davisdriving/sdp27/README.md

# sdp27
Code + Documentation for team 27's ECE senior design project at UMass Amherst, a wheeled bipedal robot built to run CFM-based ergodic coverage algorithms and execute them in real time. Its awesome.
Refer to /important to see what really makes all the difference.
