davisdriving/sdp27/hardware/hardware_notes.md

currently contains the v1 schematic of the controller PCB
