davisdriving/sdp27/hardware/kicad_schematic_v1.png

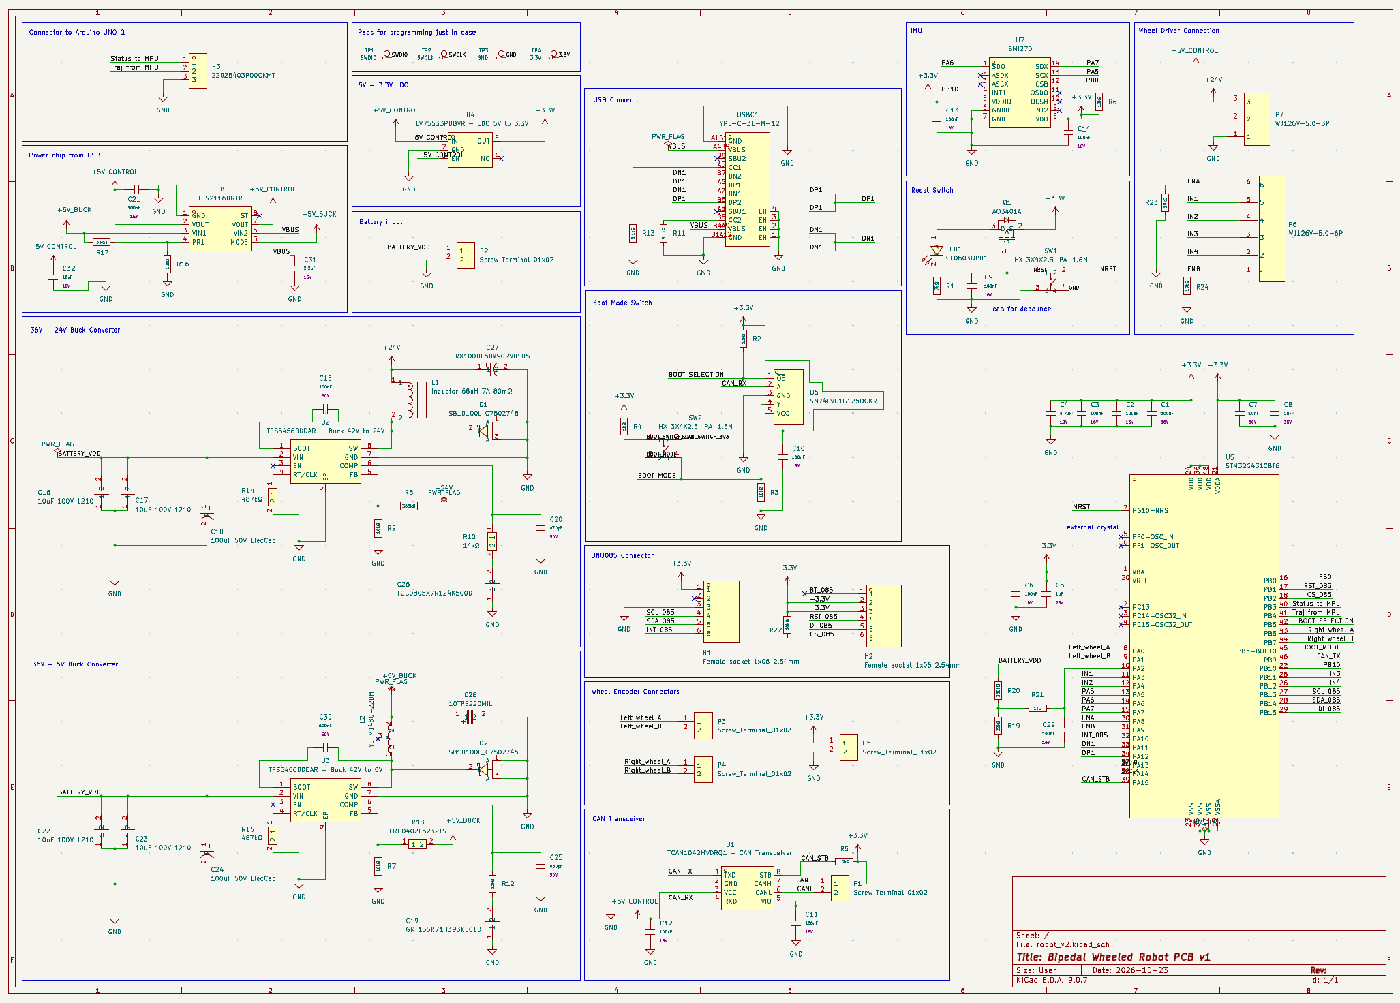
hardware/kicad_schematic_v1.png
