davisdriving/sdp27/hardware/robot_v1.kicad_sch

## KiCad design hardware/robot_v1.kicad_sch (2026-11-13)

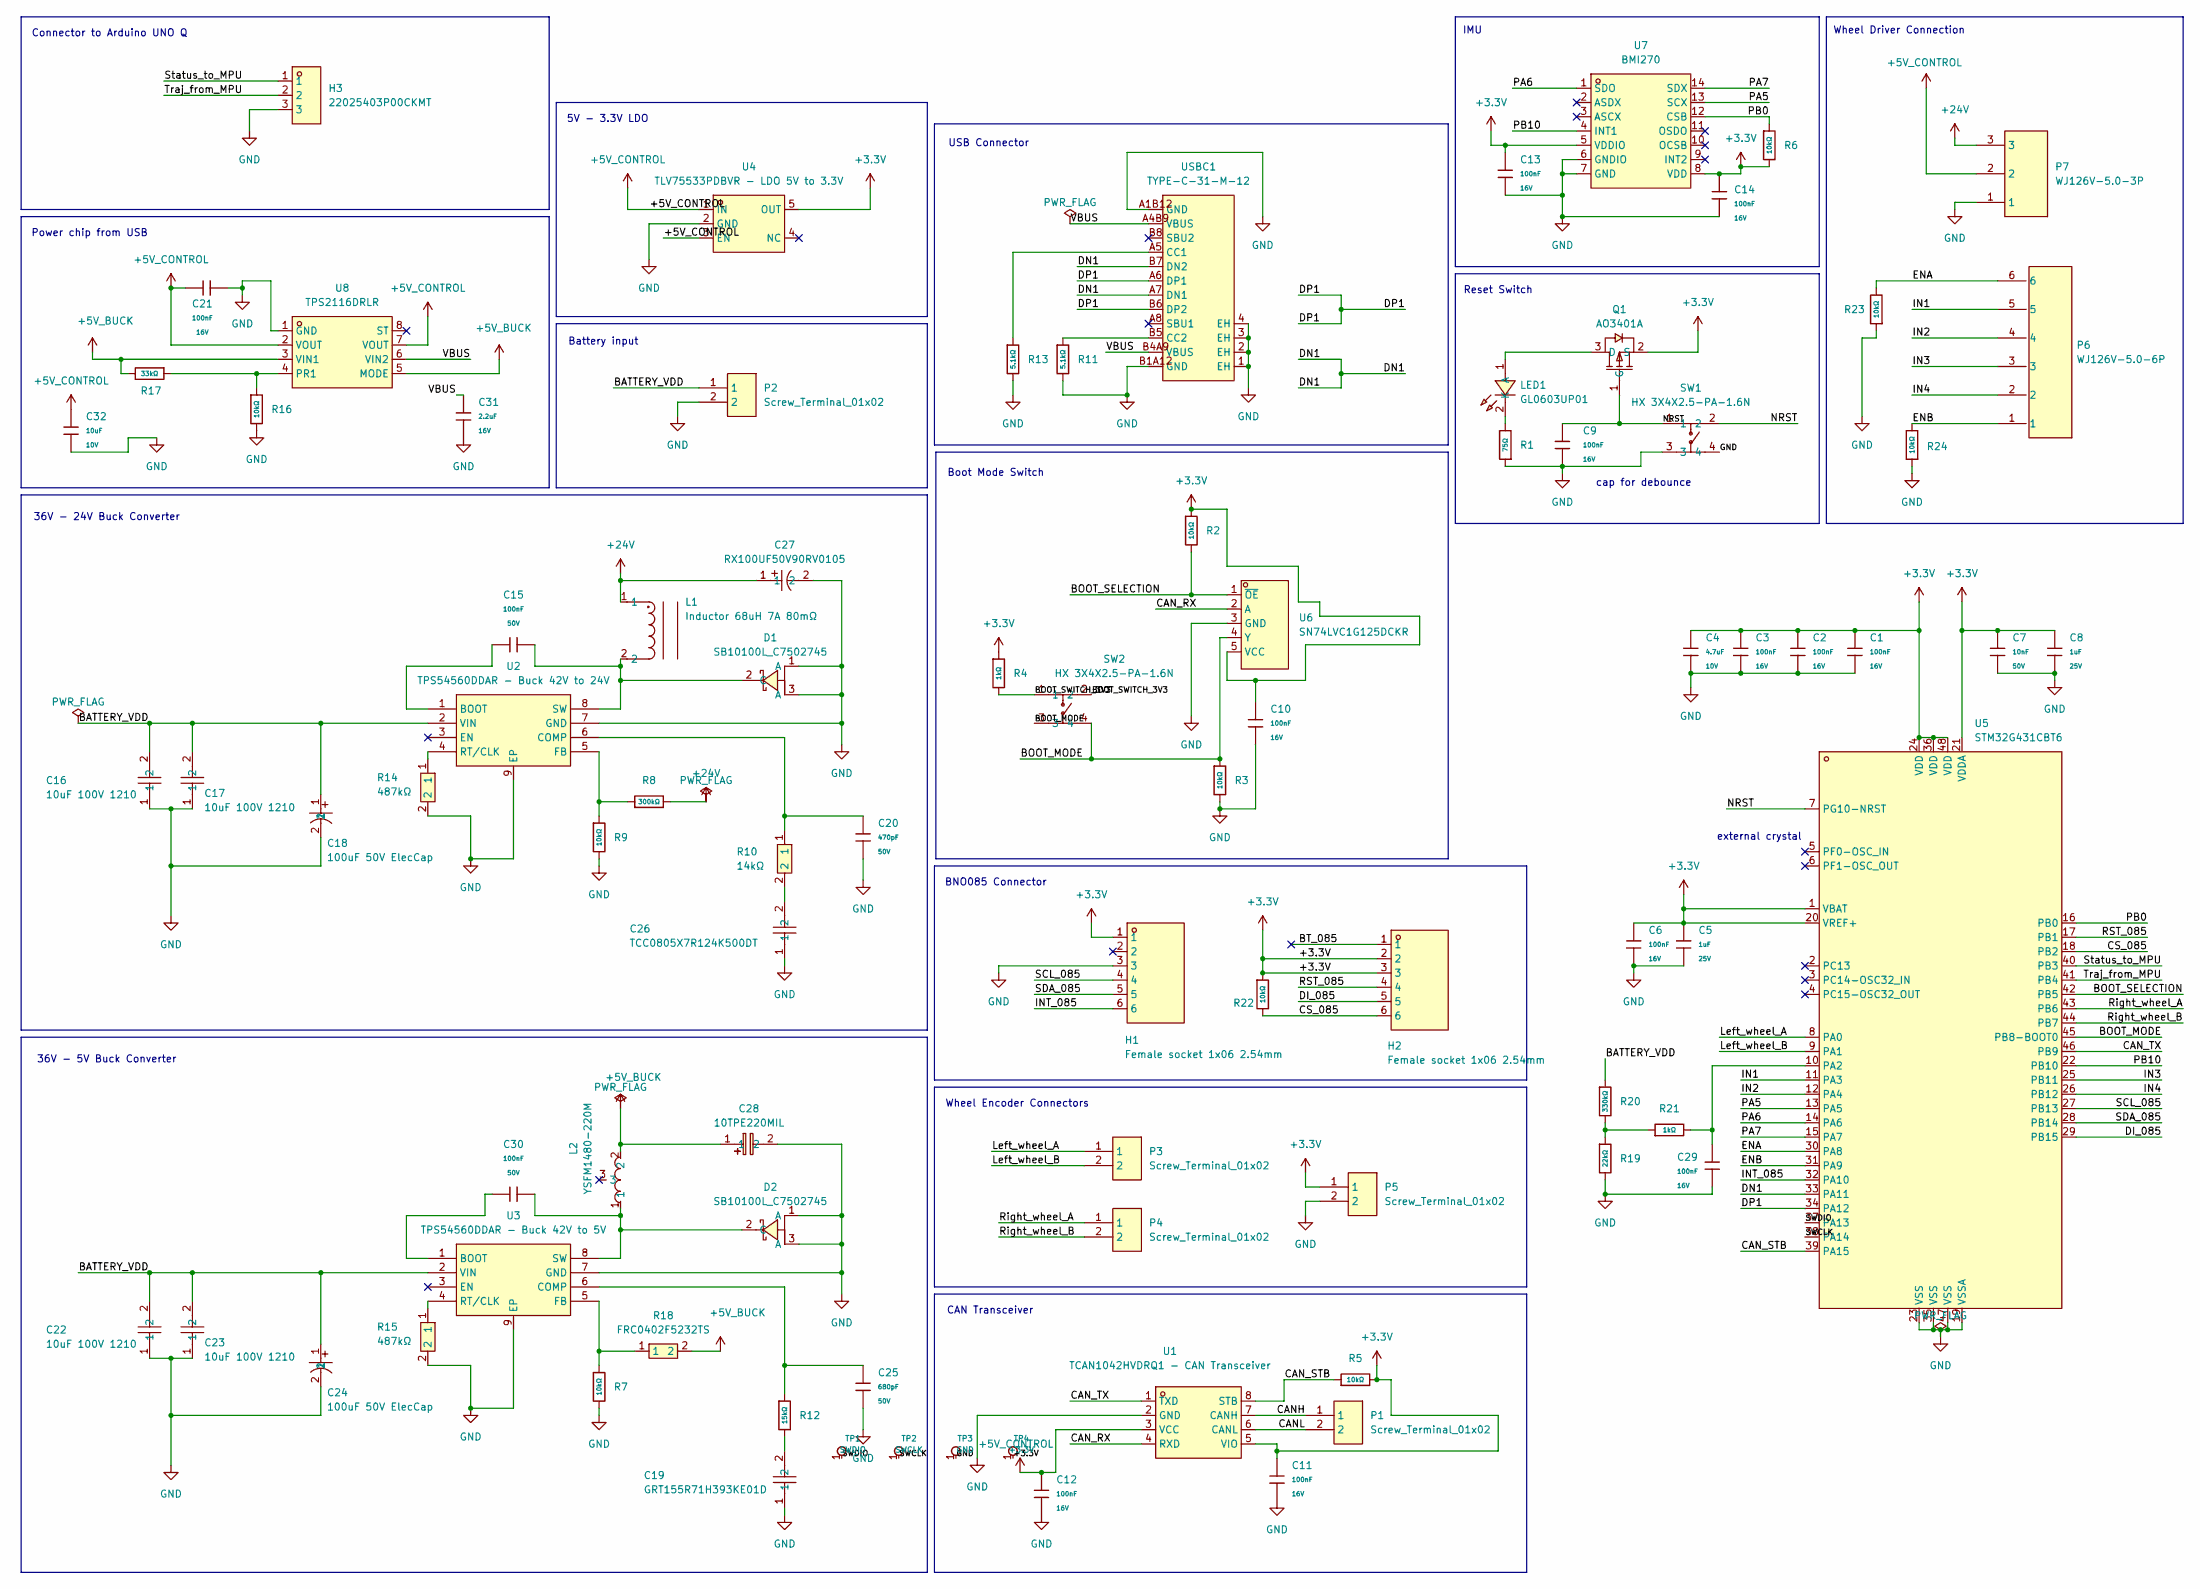
[picture p2: schematic robot_v1.kicad_sch]

Parts:
C1: 100nF; C1; Voltage Rated 16V; Tolerance ±10%; Part CL05B104KO5NNNC; LCSC C1525
C2: 100nF; C2; Voltage Rated 16V; Tolerance ±10%; Part CL05B104KO5NNNC; LCSC C1525
C3: 100nF; C3; Voltage Rated 16V; Tolerance ±10%; Part CL05B104KO5NNNC; LCSC C1525
C4: 4.7uF; C4; Voltage Rated 10V; Tolerance ±20%; Part CL05A475MP5NRNC; LCSC C23733
C5: 1uF; C5; Voltage Rated 25V; Tolerance ±10%; Part CL05A105KA5NQNC; LCSC C52923
C6: 100nF; C6; Voltage Rated 16V; Tolerance ±10%; Part CL05B104KO5NNNC; LCSC C1525
C7: 10nF; C7; Voltage Rated 50V; Tolerance ±10%; Part CL05B103KB5NNNC; LCSC C15195
C8: 1uF; C8; Voltage Rated 25V; Tolerance ±10%; Part CL05A105KA5NQNC; LCSC C52923
C9: 100nF; C9; Voltage Rated 16V; Tolerance ±10%; Part CL05B104KO5NNNC; LCSC C1525
C10: 100nF; C10; Voltage Rated 16V; Tolerance ±10%; Part CL05B104KO5NNNC; LCSC C1525
C11: 100nF; C11; Voltage Rated 16V; Tolerance ±10%; Part CL05B104KO5NNNC; LCSC C1525
C12: 100nF; C12; Voltage Rated 16V; Tolerance ±10%; Part CL05B104KO5NNNC; LCSC C1525
C13: 100nF; C13; Voltage Rated 16V; Tolerance ±10%; Part CL05B104KO5NNNC; LCSC C1525
C14: 100nF; C14; Voltage Rated 16V; Tolerance ±10%; Part CL05B104KO5NNNC; LCSC C1525
C15: 100nF; C15; Voltage Rated 50V; Tolerance ±10%; Part CL05B104KB54PNC; LCSC C307331
C16: 10uF 100V 1210; C16; MPN FS32X106K101EGG; LCSC Part C5156756
C17: 10uF 100V 1210; C17; MPN FS32X106K101EGG; LCSC Part C5156756
C18: 100uF 50V ElecCap; C18; MPN RVT1H101M0810; LCSC Part C72480
C19: GRT155R71H393KE01D; C19; MPN GRT155R71H393KE01D; LCSC Part C6627612
C20: 470pF; C20; Voltage Rated 50V; Tolerance ±10%; Part 0402B471K500NT; LCSC C1537
C21: 100nF; C21; Voltage Rated 16V; Tolerance ±10%; Part CL05B104KO5NNNC; LCSC C1525
C22: 10uF 100V 1210; C22; MPN FS32X106K101EGG; LCSC Part C5156756
C23: 10uF 100V 1210; C23; MPN FS32X106K101EGG; LCSC Part C5156756
C24: 100uF 50V ElecCap; C24; MPN RVT1H101M0810; LCSC Part C72480
C25: 680pF; C25; Voltage Rated 50V; Tolerance ±10%; Part 0603B681K500NT; LCSC C1630
C26: TCC0805X7R124K500DT; C26; MPN TCC0805X7R124K500DT; LCSC Part C376931
C27: RX100UF50V90RV0105; C27; MPN RX100UF50V90RV0105; LCSC Part C3445238
C28: 10TPE220MIL; C28; MPN 10TPE220MIL; LCSC Part C347538
C29: 100nF; C29; Voltage Rated 16V; Tolerance ±10%; Part CL05B104KO5NNNC; LCSC C1525
C30: 100nF; C30; Voltage Rated 50V; Tolerance ±10%; Part CL05B104KB54PNC; LCSC C307331
C31: 2.2uF; C31; Voltage Rated 16V; Tolerance ±10%; Part CL10A225KO8NNNC; LCSC C23630
C32: 10uF; C32; Voltage Rated 10V; Tolerance ±10%; Part CL10A106KP8NNNC; LCSC C19702
D1: SB10100L_C7502745; D1; MPN SB10100L; LCSC Part C7502745
D2: SB10100L_C7502745; D2; MPN SB10100L; LCSC Part C7502745
H1: Female socket 1x06 2.54mm; H1; MPN A2541HWV-6P; LCSC Part C225503
H2: Female socket 1x06 2.54mm; H2; MPN A2541HWV-6P; LCSC Part C225503
H3: 22025403P00CKMT; H3; MPN B-2200S03P-A120; LCSC Part C146690
L1: Inductor 68uH 7A 80mΩ; L1; MPN SMMS1770-680M; LCSC Part C2976972
L2: YSFM1480-220M; L2; MPN YSFM1480-220M; LCSC Part C7433102
LED1: GL0603UP01; LED1; MPN GL0603UP01; LCSC Part C51933299
P1: Screw_Terminal_01x02; P1; MPN WJ127-5.0-02P-14-00A; LCSC Part C3703
P2: Screw_Terminal_01x02; P2; MPN WJ127-5.0-02P-14-00A; LCSC Part C3703
P3: Screw_Terminal_01x02; P3; MPN WJ127-5.0-02P-14-00A; LCSC Part C3703
P4: Screw_Terminal_01x02; P4; MPN WJ127-5.0-02P-14-00A; LCSC Part C3703
P5: Screw_Terminal_01x02; P5; MPN WJ127-5.0-02P-14-00A; LCSC Part C3703
P6: WJ126V-5.0-6P; P6; MPN WJ126V-5.0-06P-14-00A; LCSC Part C8379
P7: WJ126V-5.0-3P; P7; MPN WJ126V-5.0-03P-14-00A; LCSC Part C8401
Q1: AO3401A; Q1; MPN AO3401A; LCSC Part C15127
R1: 75Ω; R1; Overload Voltage (Max) 50V; Tolerance ±1%; Part 0402WGF750JTCE; LCSC C25133
R2: 10kΩ; R2; Overload Voltage (Max) 50V; Tolerance ±1%; Part 0402WGF1002TCE; LCSC C25744
R3: 10kΩ; R3; Overload Voltage (Max) 50V; Tolerance ±1%; Part 0402WGF1002TCE; LCSC C25744
R4: 1kΩ; R4; Overload Voltage (Max) 50V; Tolerance ±1%; Part 0402WGF1001TCE; LCSC C11702
R5: 10kΩ; R5; Overload Voltage (Max) 50V; Tolerance ±1%; Part 0402WGF1002TCE; LCSC C25744
R6: 10kΩ; R6; Overload Voltage (Max) 50V; Tolerance ±1%; Part 0402WGF1002TCE; LCSC C25744
R7: 10kΩ; R7; Overload Voltage (Max) 50V; Tolerance ±1%; Part 0402WGF1002TCE; LCSC C25744
R8: 300kΩ; R8; Overload Voltage (Max) 50V; Tolerance ±1%; Part 0402WGF3003TCE; LCSC C25774
R9: 10kΩ; R9; Overload Voltage (Max) 50V; Tolerance ±1%; Part 0402WGF1002TCE; LCSC C25744
R10: 14kΩ; R10; MPN FRC0603F1402TS; LCSC Part C2930066
R11: 5.1kΩ; R11; Overload Voltage (Max) 50V; Tolerance ±1%; Part 0402WGF5101TCE; LCSC C25905
R12: 15kΩ; R12; Overload Voltage (Max) 50V; Tolerance ±1%; Part 0402WGF1502TCE; LCSC C25756
R13: 5.1kΩ; R13; Overload Voltage (Max) 50V; Tolerance ±1%; Part 0402WGF5101TCE; LCSC C25905
R14: 487kΩ; R14; MPN CRCW0603487KFKEA; LCSC Part C2076638
R15: 487kΩ; R15; MPN CRCW0603487KFKEA; LCSC Part C2076638
R16: 10kΩ; R16; Overload Voltage (Max) 50V; Tolerance ±1%; Part 0402WGF1002TCE; LCSC C25744
R17: 33kΩ; R17; Overload Voltage (Max) 50V; Tolerance ±1%; Part 0402WGF3302TCE; LCSC C25779
R18: FRC0402F5232TS; R18; MPN FRC0402F5232TS; LCSC Part C2998086
R19: 22kΩ; R19; Overload Voltage (Max) 50V; Tolerance ±1%; Part 0402WGF2202TCE; LCSC C25768
R20: 330kΩ; R20; Overload Voltage (Max) 75V; Tolerance ±1%; Part 0603WAF3303T5E; LCSC C23137
R21: 1kΩ; R21; Overload Voltage (Max) 50V; Tolerance ±1%; Part 0402WGF1001TCE; LCSC C11702
R22: 10kΩ; R22; Overload Voltage (Max) 50V; Tolerance ±1%; Part 0402WGF1002TCE; LCSC C25744
R23: 10kΩ; R23; Overload Voltage (Max) 50V; Tolerance ±1%; Part 0402WGF1002TCE; LCSC C25744
R24: 10kΩ; R24; Overload Voltage (Max) 50V; Tolerance ±1%; Part 0402WGF1002TCE; LCSC C25744
SW1: HX 3X4X2.5-PA-1.6N; SW1; MPN HX 3x4x2.5-PA-1.6N; LCSC Part C55200587
SW2: HX 3X4X2.5-PA-1.6N; SW2; MPN HX 3x4x2.5-PA-1.6N; LCSC Part C55200587
TP1: SWDIO; TP1
TP2: SWCLK; TP2
TP3: GND; TP3
TP4: +3.3V; TP4
U1: TCAN1042HVDRQ1 - CAN Transceiver; U1; MPN TCAN1042HVDRQ1; LCSC Part C485807
U2: TPS54560DDAR - Buck 42V to 24V; SOIC-8_L5.0-W4.0-P1.27-LS6.0-BL-EP2.0; MPN TPS54560DDAR; LCSC Part C31966
U3: TPS54560DDAR - Buck 42V to 5V; SOIC-8_L5.0-W4.0-P1.27-LS6.0-BL-EP2.0; MPN TPS54560DDAR; LCSC Part C31966
U4: TLV75533PDBVR - LDO 5V to 3.3V; U4; MPN TLV75533PDBVR; LCSC Part C404027
U5: STM32G431CBT6; U5; MPN STM32G431CBT6; LCSC Part C529355
U6: SN74LVC1G125DCKR; U6; MPN SN74LVC1G125DCKR; LCSC Part C7833
U7: BMI270; U7; MPN BMI270; LCSC Part C2836813
U8: TPS2116DRLR; U8; MPN TPS2116DRLR; LCSC Part C3235557
USBC1: TYPE-C-31-M-12; USB-C_SMD-TYPE-C-31-M-12_1; MPN TYPE-C-31-M-12; LCSC Part C165948

Connections:
+3.3V: C1.1, C2.1, C3.1, C4.1, C5.1, C6.1, C7.1, C8.1, C10.1, C11.1, C13.1, C14.1, H1.1, H2.2, H2.3, P5.1, Q1.2 (S), R2.1, R4.1, R5.2, R6.2, R22.1, TP4.1, U1.5 (VIO), U4.5 (OUT), U5.1 (VBAT), U5.20 (VREF+), U5.21 (VDDA), U5.24 (VDD), U5.36 (VDD), U5.48 (VDD), U6.5 (VCC), U7.5 (VDDIO), U7.8 (VDD)
+5V_BUCK: C28.1, L2.2, R17.2, R18.2, U8.3 (VIN1), U8.5 (MODE)
+5V_CONTROL: C12.1, C21.1, C32.1, P7.2, U1.3 (VCC), U4.1 (IN), U4.3 (EN), U8.2 (VOUT), U8.7 (VOUT)
+24V: C27.1, L1.1, P7.3, R8.2
BATTERY_VDD: C16.2, C17.2, C18.1, C22.2, C23.2, C24.1, P2.1, R20.1, U2.2 (VIN), U3.2 (VIN)
BOOT_MODE: R3.1, SW2.3, SW2.4, U5.45 (PB8-BOOT0), U6.4 (Y)
BOOT_SELECTION: R2.2, U5.42 (PB5), U6.1 (~OE)
BOOT_SWITCH_3V3: R4.2, SW2.1, SW2.2
BT_085: H2.1
CANH: P1.1, U1.7 (CANH)
CANL: P1.2, U1.6 (CANL)
CAN_RX: U1.4 (RXD), U6.2 (A)
CAN_STB: R5.1, U1.8 (STB), U5.39 (PA15)
CAN_TX: U1.1 (TXD), U5.46 (PB9)
CS_085: H2.6, R22.2, U5.18 (PB2)
DI_085: H2.5, U5.29 (PB15)
DN1: U5.33 (PA11), USBC1.A7 (DN1), USBC1.B7 (DN2)
DP1: U5.34 (PA12), USBC1.A6 (DP1), USBC1.B6 (DP2)
ENA: P6.6, R23.2, U5.30 (PA8)
ENB: P6.1, R24.2, U5.31 (PA9)
GND: C1.2, C2.2, C3.2, C4.2, C5.2, C6.2, C7.2, C8.2, C9.2, C10.2, C11.2, C12.2, C13.2, C14.2, C16.1, C17.1, C18.2, C19.1, C20.2, C21.2, C22.1, C23.1, C24.2, C25.2, C26.1, C27.2, C28.2, C29.2, C31.2, C32.2, D1.1 (A), D1.3 (A), D2.1 (A), D2.3 (A), H1.3, H3.3, P2.2, P5.2, P7.1, R1.1, R3.2, R7.2, R9.2, R11.2, R13.2, R14.2, R15.2, R16.2, R19.2, R23.1, R24.1, SW1.3, SW1.4, TP3.1, U1.2 (GND), U2.7 (GND), U2.9 (EP), U3.7 (GND), U3.9 (EP), U4.2 (GND), U5.19 (VSSA), U5.23 (VSS), U5.35 (VSS), U5.47 (VSS), U6.3 (GND), U7.6 (GNDIO), U7.7 (GND), U8.1 (GND), USBC1.1 (EH), USBC1.2 (EH), USBC1.3 (EH), USBC1.4 (EH), USBC1.A1B12 (GND), USBC1.B1A12 (GND)
IN1: P6.5, U5.11 (PA3)
IN2: P6.4, U5.12 (PA4)
IN3: P6.3, U5.25 (PB11)
IN4: P6.2, U5.26 (PB12)
INT_085: H1.6, U5.32 (PA10)
Left_wheel_A: P3.1, U5.8 (PA0)
Left_wheel_B: P3.2, U5.9 (PA1)
NRST: C9.1, Q1.1 (G), SW1.1, SW1.2, U5.7 (PG10-NRST)
unnamed: C15.1, U2.1 (BOOT)
unnamed: C15.2, D1.2 (C), L1.2, U2.8 (SW)
unnamed: C19.2, R12.2
unnamed: C20.1, R10.1, U2.6 (COMP)
unnamed: C25.1, R12.1, U3.6 (COMP)
unnamed: C26.2, R10.2
unnamed: C29.1, R21.2, U5.10 (PA2)
unnamed: C30.1, U3.1 (BOOT)
unnamed: C30.2, D2.2 (C), L2.1, U3.8 (SW)
unnamed: LED1.1 (A), Q1.3 (D)
unnamed: LED1.2 (K), R1.2
unnamed: R8.1, R9.1, U2.5 (FB)
unnamed: R11.1, USBC1.B5 (CC2)
unnamed: R13.1, USBC1.A5 (CC1)
unnamed: R14.1, U2.4 (RT/CLK)
unnamed: R15.1, U3.4 (RT/CLK)
unnamed: R16.1, R17.1, U8.4 (PR1)
unnamed: R7.1, R18.1, U3.5 (FB)
unnamed: R19.1, R20.2, R21.1
PA5: U5.13 (PA5), U7.13 (SCX)
PA6: U5.14 (PA6), U7.1 (SDO)
PA7: U5.15 (PA7), U7.14 (SDX)
PB0: R6.1, U5.16 (PB0), U7.12 (CSB)
PB10: U5.22 (PB10), U7.4 (INT1)
RST_085: H2.4, U5.17 (PB1)
Right_wheel_A: P4.1, U5.43 (PB6)
Right_wheel_B: P4.2, U5.44 (PB7)
SCL_085: H1.4, U5.27 (PB13)
SDA_085: H1.5, U5.28 (PB14)
SWCLK: TP2.1, U5.38 (PA14)
SWDIO: TP1.1, U5.37 (PA13)
Status_to_MPU: H3.1, U5.40 (PB3)
Traj_from_MPU: H3.2, U5.41 (PB4)
VBUS: C31.1, U8.6 (VIN2), USBC1.A4B9 (VBUS), USBC1.B4A9 (VBUS)

Notes on the sheet:
Wheel Encoder Connectors
36V - 24V Buck Converter
Battery input
external crystal
IMU
CAN Transceiver
Connector to Arduino UNO Q
Reset Switch
Power chip from USB
Wheel Driver Connection
36V - 5V Buck Converter
5V - 3.3V LDO
Boot Mode Switch
cap for debounce
BNO085 Connector
USB Connector
