davisdriving/sdp27/(commit log)

2026-09-30 Added stepper bot PID control testing code
2026-10-06 added gyroscope control for derivative term
2026-11-10 logging torque data
2026-11-13 uploaded kicad schematic for PCB
    [robot_v1.kicad_sch]
2026-11-13 image of schematic
